tkrahn/pecanpico5a/README.md

pecanpico5a
===========

The fifth version of the Pecan Pico board and the associated software. Note that the Rx/Tx lines from the micro to the gps are switched. This requires soldering a crossover bridge.
