tkrahn/pecanpico5a/PecanPico5a.brd.pdf

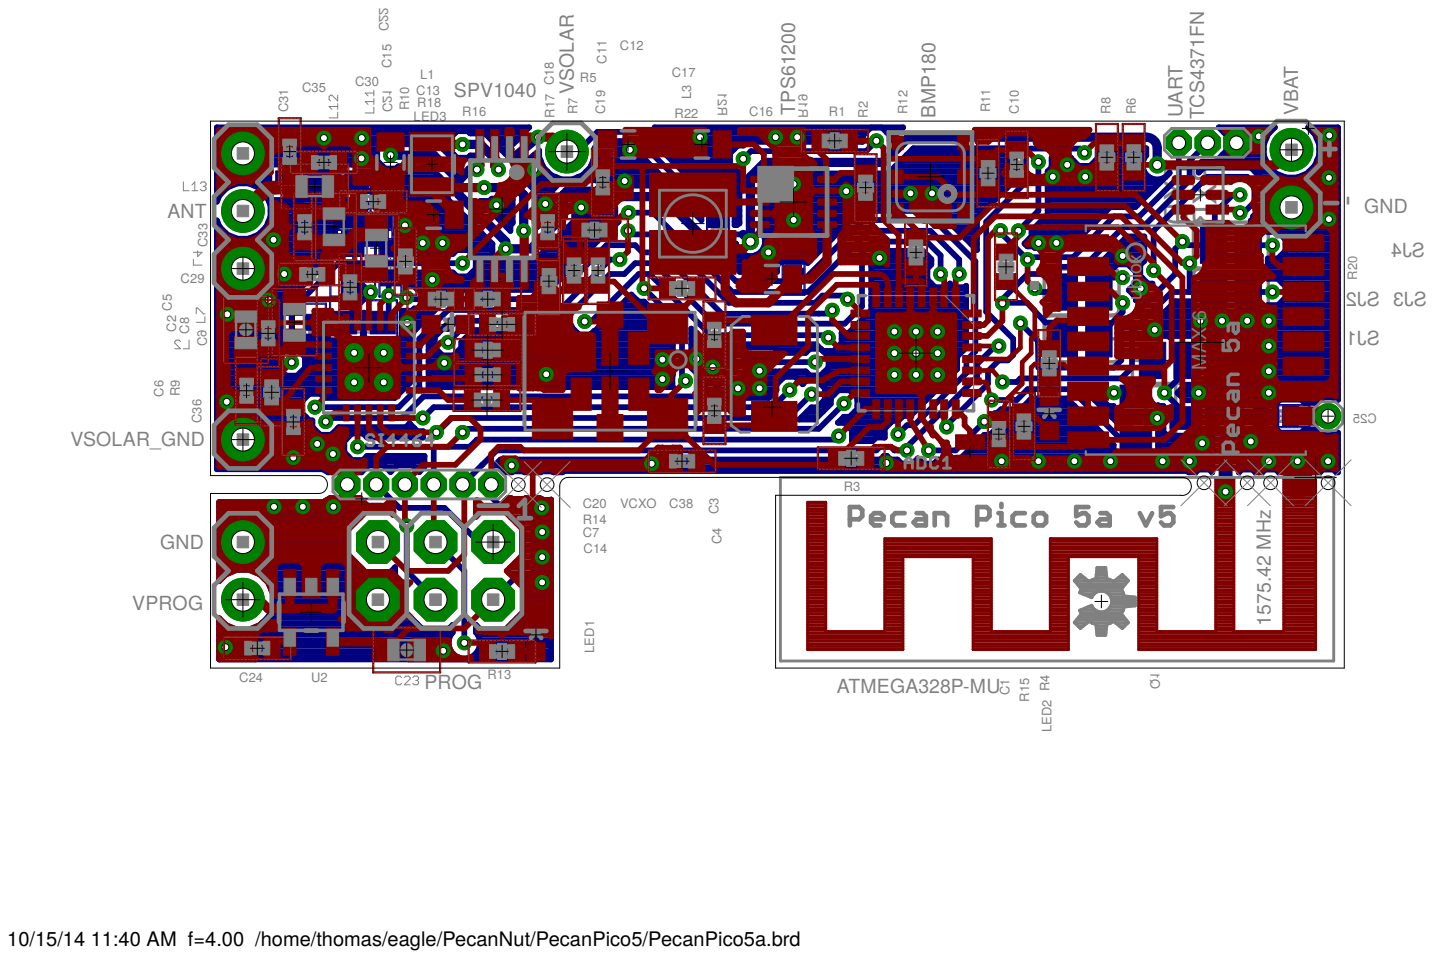
[picture p1: page 1]

10/15/14 11:40 AM f=4.00 /home/thomas/eagle/PecanNut/PecanPico5/PecanPico5a.brd
