tkrahn/pecanpico5a/PecanPico5a.sch.pdf

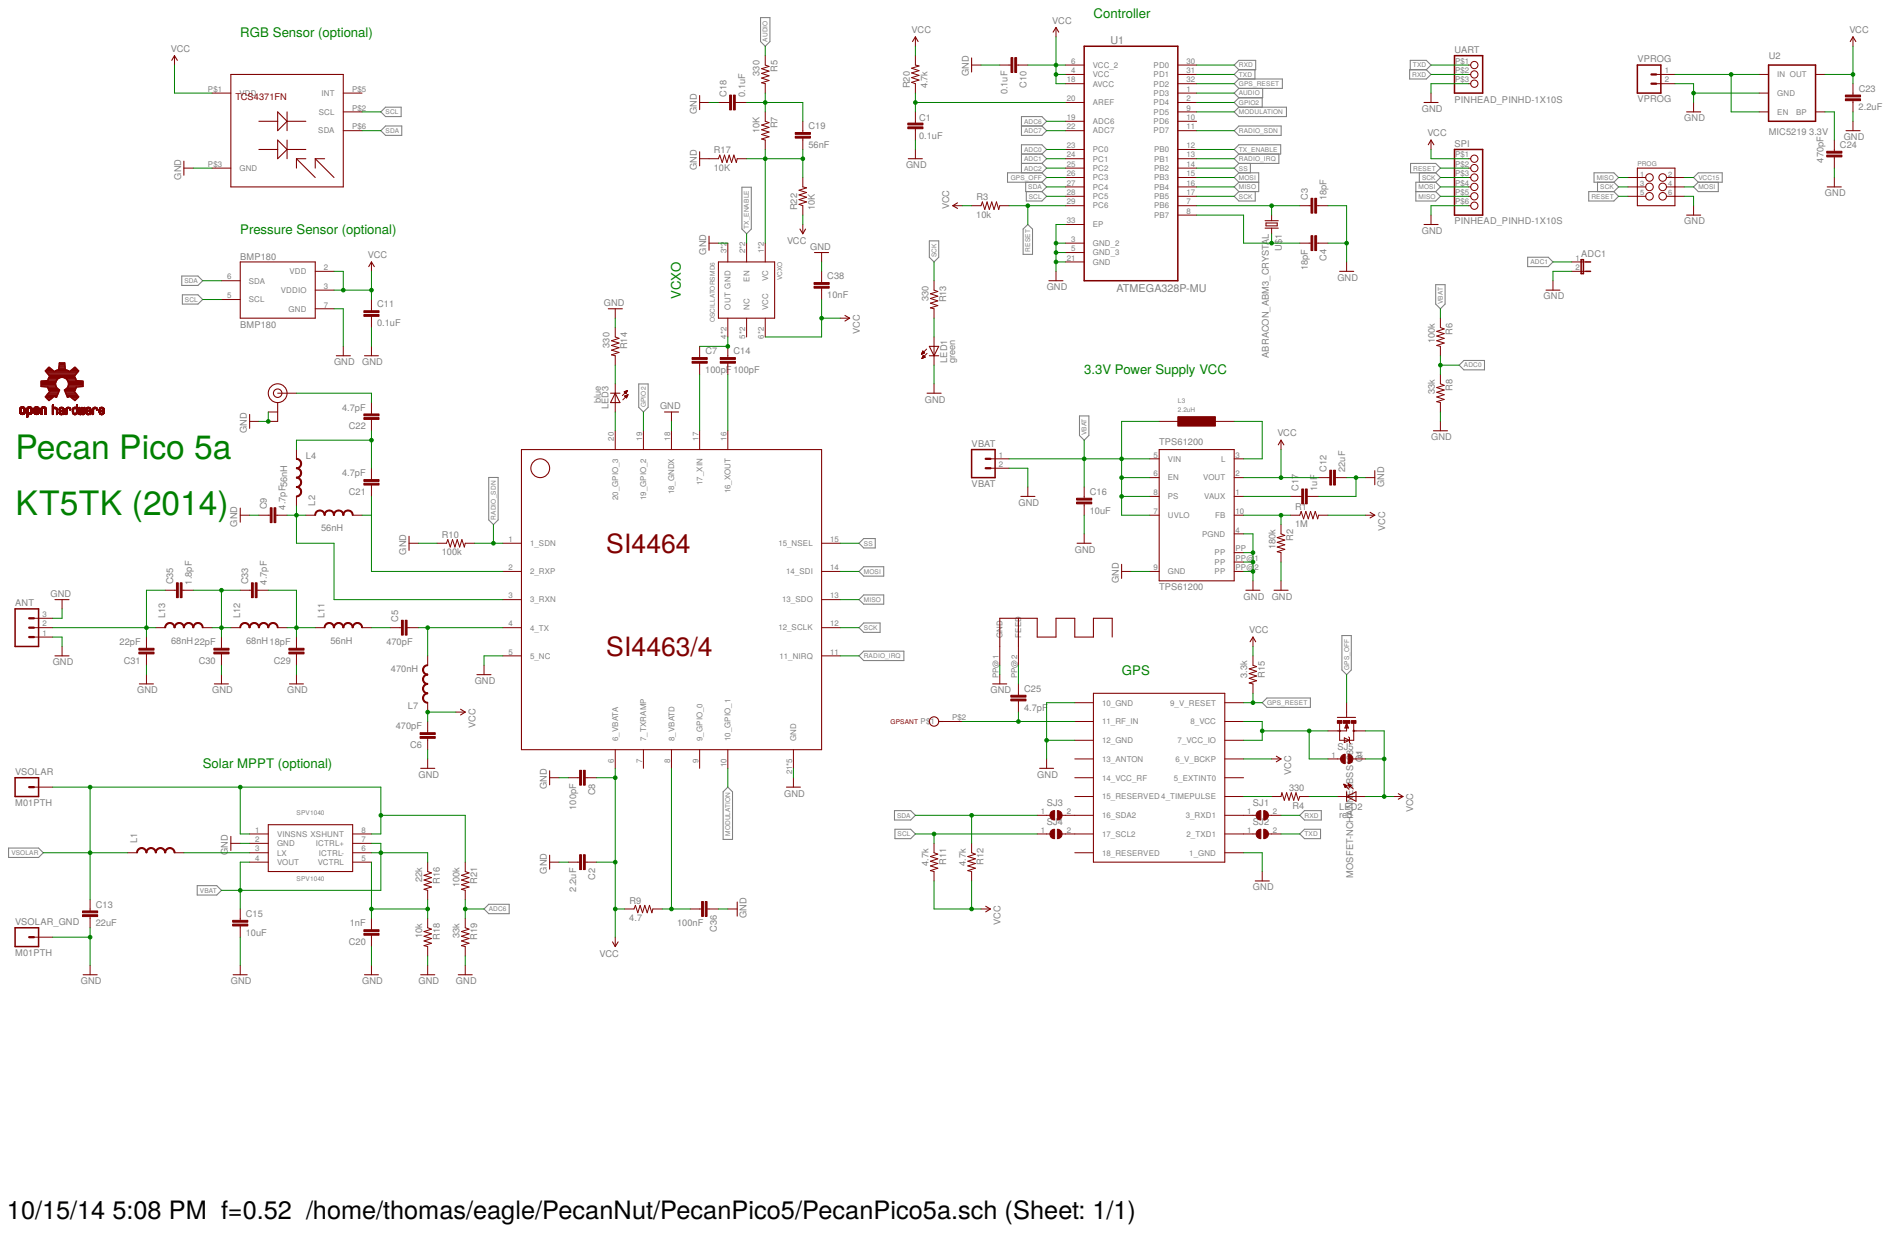
[picture p2: page 1]

10/15/14 5:08 PM f=0.52 /home/thomas/eagle/PecanNut/PecanPico5/PecanPico5a.sch (Sheet: 1/1)
