tkrahn/pecanpico5a/PecanPico5a.brd

## EAGLE design PecanPico5a.brd (2014-10-24)

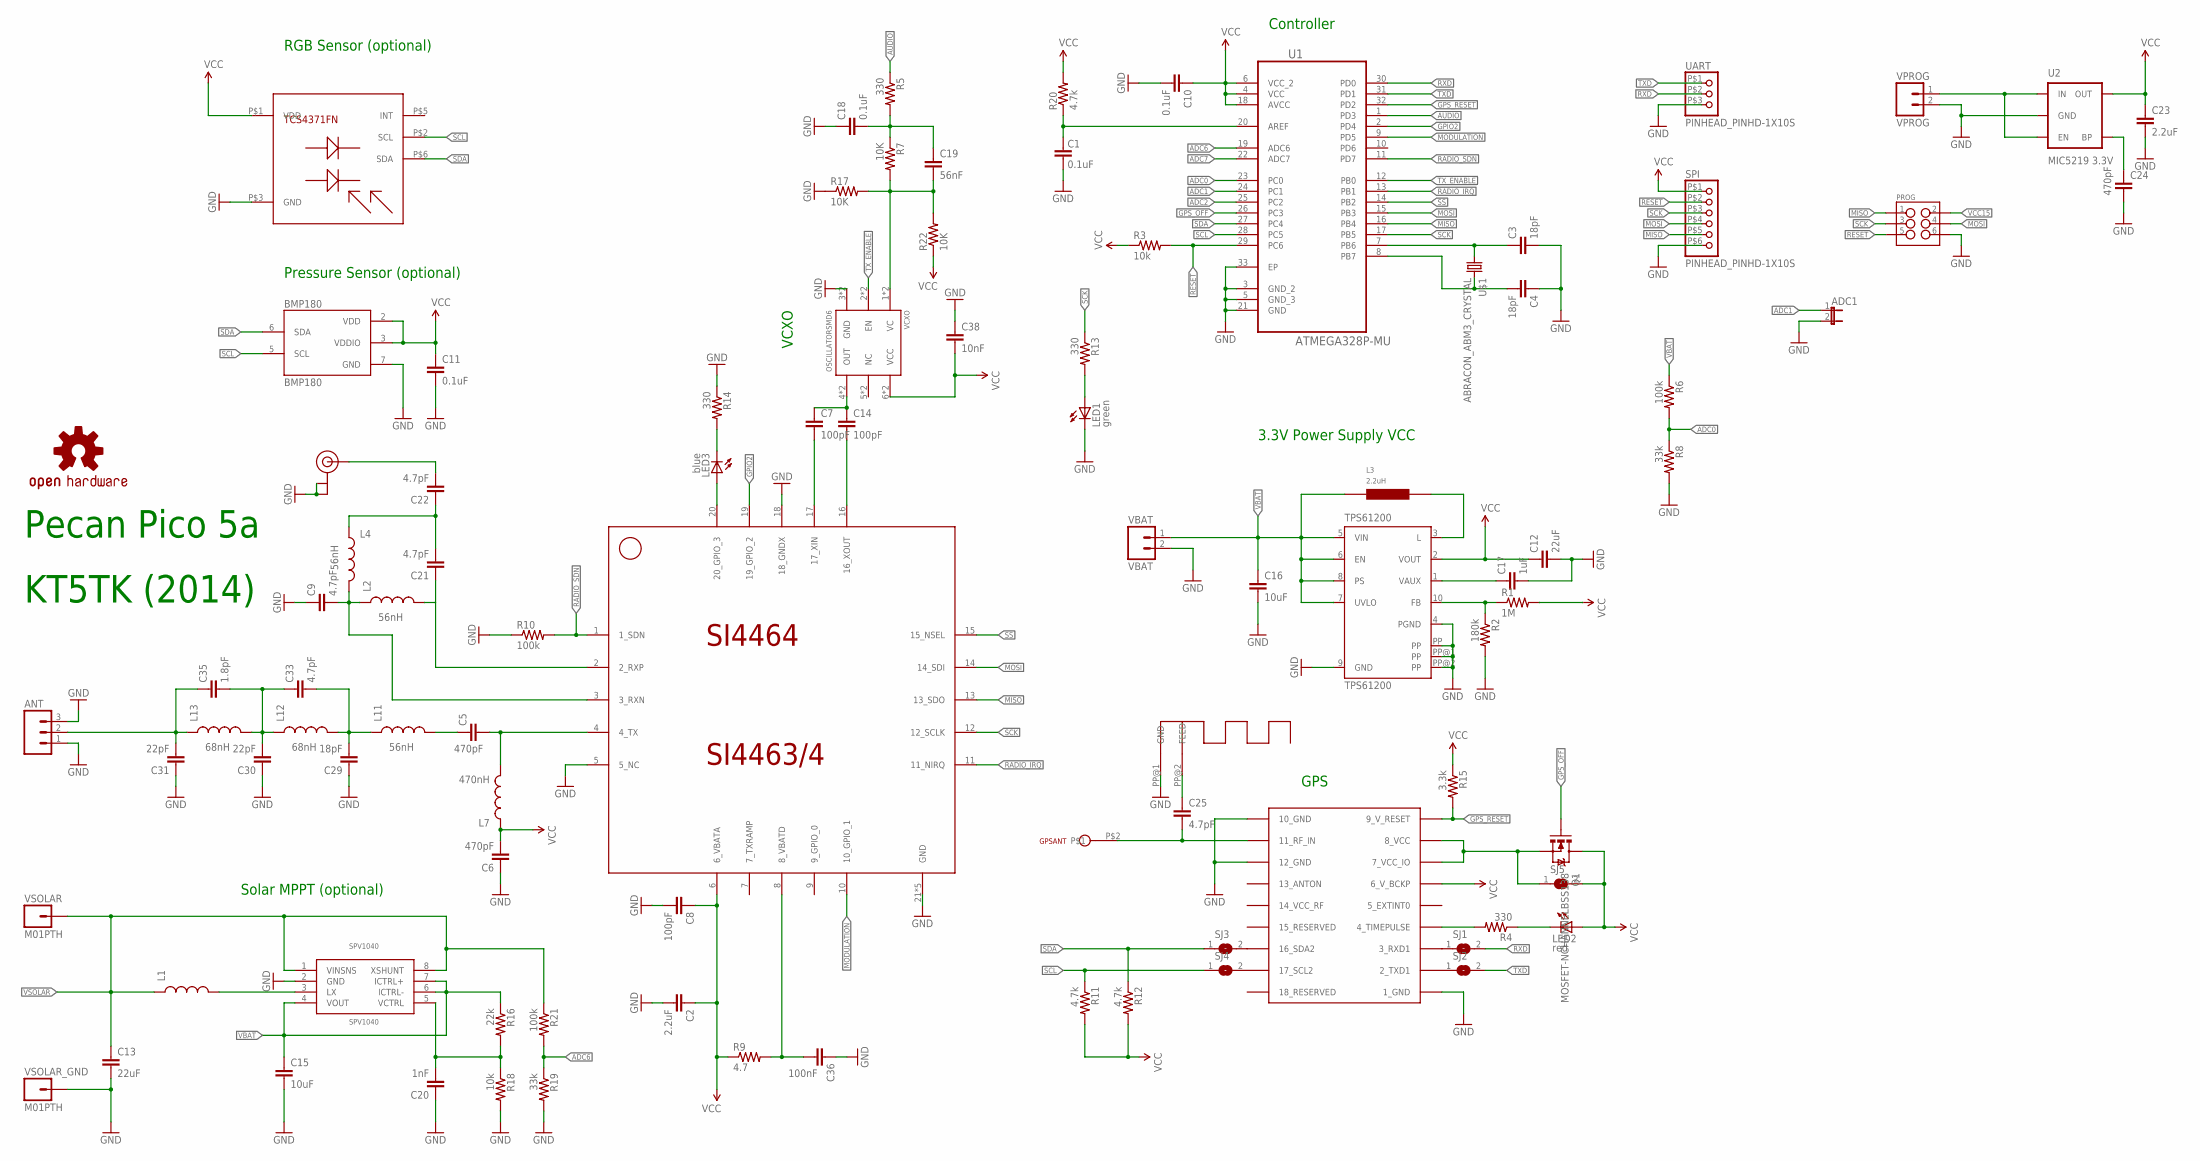
[picture p3: schematic PecanPico5a.sch]

Parts:
ADC1: JUMPER-2SMD-NO-NS; SJ_2S-NO-NS
ANT: M03PTH; 1X03
BMP180: BMP180
C1, C10, C11, C18: 0.1uF; 0402-CAP
C2, C23: 2.2uF; 0603-CAP
C3, C4, C29: 18pF; 0402-CAP
C5, C6, C24: 470pF; 0402-CAP
C7, C8, C14: 100pF; 0402-CAP
C9, C21, C22, C25, C33: 4.7pF; 0402-CAP
C12, C13: 22uF; 0805
C15, C16: 10uF; 0805
C17: 1uF; 0805
C19: 56nF; 0402-CAP
C20: 1nF; 0402-CAP
C30, C31: 22pF; 0402-CAP
C35: 1.8pF; 0402-CAP
C36: 100nF; 0402-CAP
C38: 10nF; 0402-CAP
GPSANT: 1X1S; 1_27X1_PINHEAD_1X10S
L1: SPARKFUN_INDUCTOR1007; SPARKFUN_1007
L2, L4, L11: 56nH; 0603
L3: 2.2uH; LPS3015
L7: 470nH; 0603
L12, L13: 68nH; 0603
LED1: green; LED-0603
LED2: red; LED-0603
LED3: blue; LED-0603
LOGO1: OSHW-LOGOS; OSHW-LOGO-S
PROG: M03X22X3_SILK_SM; 2X3
Q1: MOSFET-NCHANNELBSS138; SOT23
R1: 1M; 0402-RES
R2: 180k; 0402-RES
R3, R18: 10k; 0402-RES
R4, R5, R13, R14: 330; 0402-RES
R6, R10, R21: 100k; 0402-RES
R7, R17, R22: 10K; 0402-RES
R8, R19: 33k; 0402-RES
R9: 4.7; 0402-RES
R11, R12, R20: 4.7k; 0402-RES
R15: 3.3k; 0402-RES
R16: 22k; 0402-RES
SI4464: SI4463/4; QFN-20
SJ1, SJ2, SJ3, SJ4, SJ5: SJ
SPI: PINHEAD_PINHD-1X10S; PINHEAD_1X10S
SPV1040: SPV1040; TSSOP8
TCS4371FN: TCS4371FN; TCS3471FN
TPS61200: TPS61200; S-PDSO-N10
U1: ATMEGA328P-MU; QFN50P500X500X100-33N
U2: MIC5219 3.3V; SOT23-5
U$1: ABRACON_ABM3_CRYSTAL
U$2: U.FL
U$3: UBLOX_MAX-6
U$4: GPS_MEANDER; GPS_INV_F_MEANDER
UART: PINHEAD_PINHD-1X10S; PINHEAD_1X10S
VBAT: VBAT; 1X02
VCXO: OSCILLATORSMD6; CRYSTAL-SMD-7.5X5.2-6PIN
VPROG: VPROG; 1X02
VSOLAR: M01PTH; 1X01
VSOLAR_GND: M01PTH; 1X01

Connections:
ADC0: R6.2, R8.1, U1.23 (PC0)
ADC1: ADC1.1, U1.24 (PC1)
ADC2: U1.25 (PC2)
ADC6: R19.1, R21.2, U1.19 (ADC6)
ADC7: U1.22 (ADC7)
AREF: C1.2, R20.1, U1.20 (AREF)
AUDIO: R5.1, U1.1 (PD3)
GND: ADC1.2, ANT.1, ANT.3, BMP180.7 (GND), C1.1, C2.2, C3.2, C4.1, C6.1, C8.2, C9.1, C10.2, C11.2, C12.2, C13.2, C15.2, C16.2, C17.2, C18.1, C20.1, C23.2, C24.2, C29.1, C30.1, C31.1, C36.1, C38.1, LED1.C, PROG.6, R2.2, R8.2, R10.1, R14.1, R17.1, R18.2, R19.2, SI4464.5 (5_NC), SI4464.18 (18_GNDX), SI4464.21 (GND), SI4464.22 (GND), SI4464.23 (GND), SI4464.24 (GND), SI4464.25 (GND), SPI.P$6 (6), SPV1040.2 (GND), TCS4371FN.P$3 (GND), TPS61200.4 (PGND), TPS61200.9 (GND), TPS61200.PP, TPS61200.PP@1 (PP), TPS61200.PP@2 (PP), U1.3 (GND_2), U1.5 (GND_3), U1.21 (GND), U1.33 (EP), U2.2 (GND), U$2.P$1 (GND), U$2.P$2 (GND), U$3.1_GND, U$3.10_GND, U$3.12_GND, U$4.PP@1 (GND), UART.P$3 (3), VBAT.2, VCXO.3 (GND), VCXO.3INNER (GND), VPROG.2, VSOLAR_GND.1
GPIO2: SI4464.19 (19_GPIO_2), U1.2 (PD4)
GPS_OFF: Q1.1 (G), U1.26 (PC3)
GPS_RESET: R15.2, U1.32 (PD2), U$3.9_V_RESET
MISO: PROG.1, SI4464.13 (13_SDO), SPI.P$5 (5), U1.16 (PB4)
MOD1: C18.2, C19.1, R5.2, R7.1
MODULATION: SI4464.10 (10_GPIO_1), U1.9 (PD5)
MOSI: PROG.4, SI4464.14 (14_SDI), SPI.P$4 (4), U1.15 (PB3)
unnamed: C14.2, SI4464.16 (16_XOUT)
unnamed: C25.2, GPSANT.P$2, U$3.11_RF_IN
unnamed: L3.P$2 (2), TPS61200.3 (L)
unnamed: R1.1, R2.1, TPS61200.10 (FB)
unnamed: LED2.C, R4.1
unnamed: C17.1, TPS61200.1 (VAUX)
unnamed: R4.2, U$3.4_TIMEPULSE
unnamed: C3.1, U1.7 (PB6), U$1.P$1 (1)
unnamed: C4.2, U1.8 (PB7), U$1.P$2 (2)
unnamed: C7.1, C14.1, VCXO.4 (OUT), VCXO.4INNER (OUT)
unnamed: SJ1.1, U$3.3_RXD1
unnamed: SJ2.1, U$3.2_TXD1
unnamed: C19.2, R7.2, R17.2, R22.2, VCXO.1 (VC), VCXO.1INNER (VC)
unnamed: LED1.A, R13.2
unnamed: C5.2, L7.2, SI4464.4 (4_TX)
unnamed: C21.1, L2.2, SI4464.2 (2_RXP)
unnamed: SJ3.2, U$3.16_SDA2
unnamed: SJ4.2, U$3.17_SCL2
unnamed: C5.1, L11.2
unnamed: C30.2, C33.1, C35.2, L12.1, L13.2
unnamed: LED3.A, SI4464.20 (20_GPIO_3)
unnamed: LED3.C, R14.2
unnamed: C7.2, SI4464.17 (17_XIN)
unnamed: L1.2, SPV1040.3 (LX)
unnamed: C9.2, L2.1, L4.2, SI4464.3 (3_RXN)
unnamed: C29.2, C33.2, L11.1, L12.2
unnamed: ANT.2, C31.2, C35.1, L13.1
unnamed: C20.2, R16.2, R18.1, SPV1040.5 (VCTRL)
unnamed: C21.2, C22.1, L4.1
unnamed: Q1.2 (S), SJ5.1, U$3.7_VCC_IO, U$3.8_VCC
unnamed: C22.2, U$2.P$3 (SIGNAL)
unnamed: U2.1 (IN), U2.3 (EN), VPROG.1
unnamed: C36.2, R9.2, SI4464.8 (8_VBATD)
unnamed: C24.1, U2.4 (BP)
unnamed: C25.1, U$4.PP@2 (FEED)
RADIO_IRQ: SI4464.11 (11_NIRQ), U1.13 (PB1)
RADIO_SDN: R10.2, SI4464.1 (1_SDN), U1.11 (PD7)
RESET: PROG.5, R3.2, SPI.P$2 (2), U1.29 (PC6)
RXD: SJ1.2, U1.30 (PD0), UART.P$2 (2)
SCK: PROG.3, R13.1, SI4464.12 (12_SCLK), SPI.P$3 (3), U1.17 (PB5)
SCL: BMP180.5 (SCL), R11.1, SJ4.1, TCS4371FN.P$2 (SCL), U1.28 (PC5)
SDA: BMP180.6 (SDA), R12.1, SJ3.1, TCS4371FN.P$6 (SDA), U1.27 (PC4)
SS: SI4464.15 (15_NSEL), U1.14 (PB2)
TXD: SJ2.2, U1.31 (PD1), UART.P$1 (1)
TX_ENABLE: U1.12 (PB0), VCXO.2 (EN), VCXO.2INNER (EN)
VBAT: C15.1, C16.1, L3.P$1 (1), R6.1, R16.1, SPV1040.4 (VOUT), SPV1040.6 (ICTRL-), SPV1040.7 (ICTRL+), TPS61200.5 (VIN), TPS61200.6 (EN), TPS61200.7 (UVLO), TPS61200.8 (PS), VBAT.1
VCC15: BMP180.2 (VDD), BMP180.3 (VDDIO), C2.1, C6.2, C8.1, C10.1, C11.1, C12.1, C23.1, C38.2, L7.1, LED2.A, PROG.2, Q1.3 (D), R1.2, R3.1, R9.1, R11.2, R12.2, R15.1, R20.2, R22.1, SI4464.6 (6_VBATA), SJ5.2, SPI.P$1 (1), TCS4371FN.P$1 (VDD), TPS61200.2 (VOUT), U1.4 (VCC), U1.6 (VCC_2), U1.18 (AVCC), U2.5 (OUT), U$3.6_V_BCKP, VCXO.6 (VCC), VCXO.6INNER (VCC)
VSOLAR: C13.1, L1.1, R21.1, SPV1040.1 (VINSNS), SPV1040.8 (XSHUNT), VSOLAR.1

Notes on the sheet:
KT5TK (2014)
Controller
3.3V Power Supply VCC
GPS
VCXO
Pressure Sensor (optional)
RGB Sensor (optional)
Pecan Pico 5a
Solar MPPT (optional)

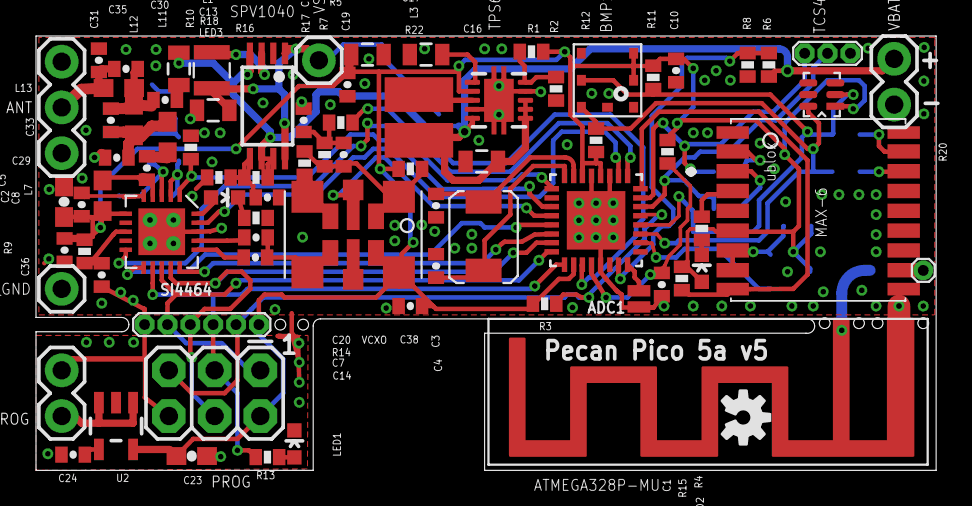
[picture p4: board PecanPico5a.brd from above]

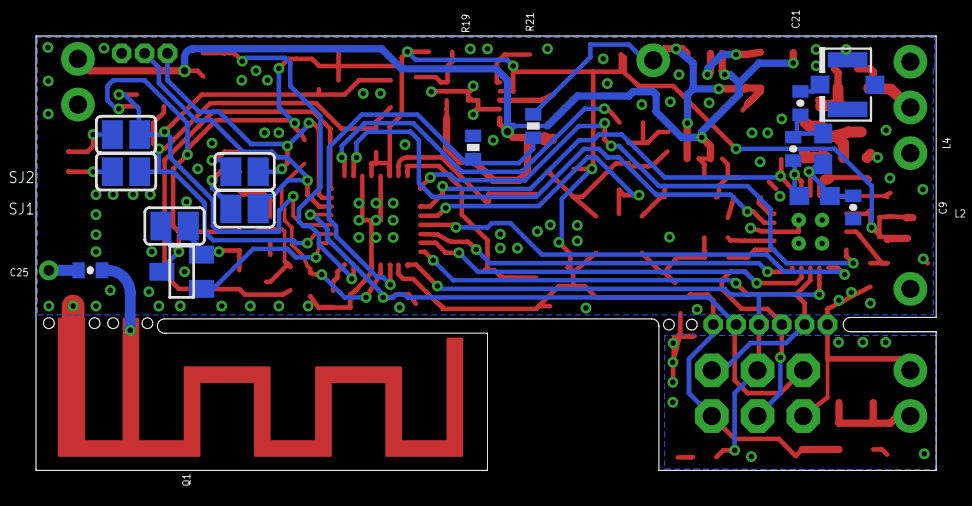
[picture p5: board PecanPico5a.brd from below]

Board: 2 copper layers, 50.0 x 24.1 mm, 94 parts (15 on the bottom side), 61 nets.
