tkrahn/pecanpico5a/(commit log)

2014-10-24 Added Eagle files & Gerbers
    [PecanPico5a.brd, PecanPico5a.sch]
2015-04-16 Update radio_si446x.cpp
    According to AN633 (https://www.silabs.com/Support%20Documents/TechnicalDocs/AN633.pdf, p.15 chapter 7.2.1.) the CTS state is reported vie SPI in the 8 SCLK cycles after issuing READ_CMD_BUFF (0x44).
    The value returned in parallel while issuing READ_CMD_BUFF is (at least in my case) not a valid CTS state. As the code interpreted the value returned in parallel as the CTS state, the reply loop, waiting for CTS=0xFF, never ended.
    Fixed by inserting another SPI.transfer just before. Now each loop takes 16 SCLK cycles.
    [radio_si446x.cpp]
